kailyn-calypso/trapSync/README.md

# trapSync
Code assembly for a remote access and controlled trap using FireBase, the Arduino Nano ESP32, and deep-sleep mode.
