kailyn-calypso/trapSync/CDL_Code/Firebase_AND_dETECT_Without_info.txt

#include <Arduino.h>
#if defined(ESP32)
  #include <WiFi.h>
#elif defined(ESP8266)
  #include <ESP8266WiFi.h>
#endif
#include <Firebase_ESP_Client.h>

//Provide the token generation process info.
#include "addons/TokenHelper.h"
//Provide the RTDB payload printing info and other helper functions.
#include "addons/RTDBHelper.h"

// Insert your network credentials
#define WIFI_SSID "wuFU"
#define WIFI_PASSWORD "PASSWOR"

// Insert Firebase project API Key
#define API_KEY "APII"

// Insert RTDB URLefine the RTDB URL */
#define DATABASE_URL "https://esp32-fURLL/" 

//Define Firebase Data object
FirebaseData fbdo;

FirebaseAuth auth;
FirebaseConfig config;

#define SENSOR_PIN 2  // Adjust this to the pin you're using
#define LED_PIN 7

unsigned long sendDataPrevMillis = 0;
int count = 0;
bool signupOK = false;

void setup(){
  Serial.begin(115200);
  pinMode(SENSOR_PIN, INPUT);
  pinMode(LED_PIN, OUTPUT);
  WiFi.begin(WIFI_SSID, WIFI_PASSWORD);
  Serial.print("Connecting to Wi-Fi");
  while (WiFi.status() != WL_CONNECTED){
    Serial.print(".");
    delay(300);
  }
  Serial.println();
  Serial.print("Connected with IP: ");
  Serial.println(WiFi.localIP());
  Serial.println();

  /* Assign the api key (required) */
  config.api_key = API_KEY;

  /* Assign the RTDB URL (required) */
  config.database_url = DATABASE_URL;

  /* Sign up */
  if (Firebase.signUp(&config, &auth, "", "")){
    Serial.println("ok");
    signupOK = true;
  }
  else{
    Serial.printf("%s\n", config.signer.signupError.message.c_str());
  }

  /* Assign the callback function for the long running token generation task */
  config.token_status_callback = tokenStatusCallback; //see addons/TokenHelper.h
  
  Firebase.begin(&config, &auth);
  Firebase.reconnectWiFi(true);
  
}

void loop() {
  
  static bool lastSensorState = LOW;
  digitalWrite(LED_PIN, LOW);
  // Read sensor pin state
  bool sensorState = digitalRead(SENSOR_PIN);

  // Detect rising edge: LOW -> HIGH
  if (sensorState == LOW && lastSensorState == HIGH) {
    Serial.println("Mouse detected!");
    digitalWrite(LED_PIN, HIGH);
    if (Firebase.ready() && signupOK) {
      // Send "mouse_detected" = true to Firebase
      if (Firebase.RTDB.setBool(&fbdo, "mouse_detected", true)) {
        Serial.println("mouse_detected set to true!");
      } else {
        Serial.println("FAILED to set mouse_detected: " + fbdo.errorReason());
      }

      // Wait for "Open_door" to become true
      bool doorOpen = false;
      Serial.println("Waiting for Open_door to be true...");
      while (!doorOpen) {
        if (Firebase.RTDB.getBool(&fbdo, "Open_door")) {
          doorOpen = fbdo.boolData();
          Serial.println("Open_door: " + String(doorOpen));
        } else {
          Serial.println("FAILED to read Open_door: " + fbdo.errorReason());
        }
        delay(1000);  // Avoid spamming requests
      }

      Serial.println("Door is open! Proceeding...");
    }

    lastSensorState = sensorState;
  }
}
